pollen-robotics/power-supply-board/power_supply_board.step

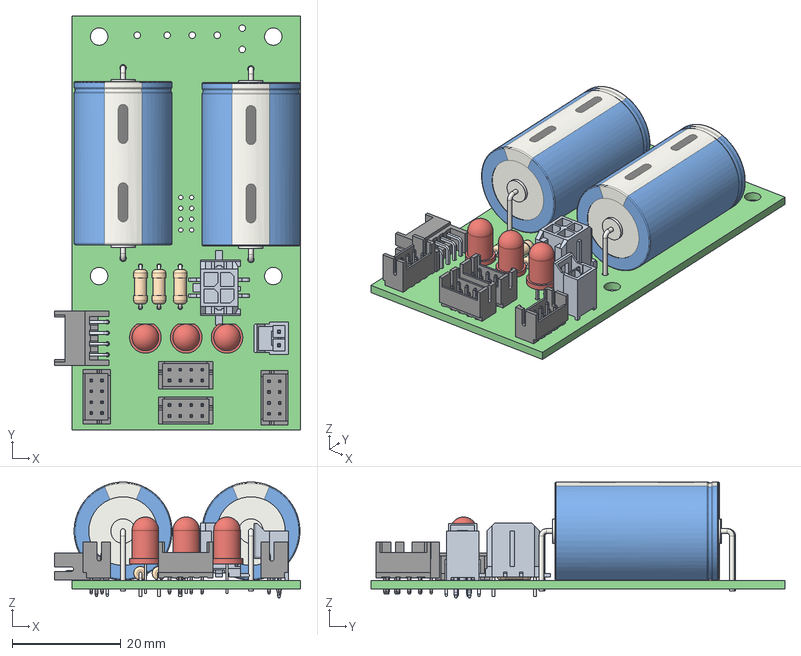
[picture p2: CAD file, 2021-06-08]
power_supply_board.step
45.2 x 76.0 x 21.3 mm
