pollen-robotics/power-supply-board/3D_components/DF11-8DP-2DSA.stp

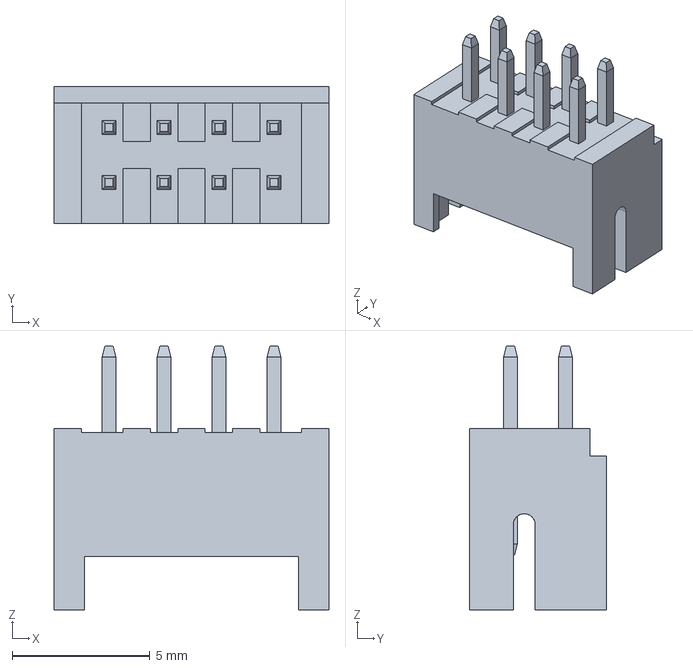
[picture p3: CAD file, 2021-02-04]
3D_components/DF11-8DP-2DSA.stp
10.0 x 5.00 x 9.60 mm
