pollen-robotics/power-supply-board/3D_components/Molex_Nano-Fit_105313-xx02_1x02_P2.50mm_Horizontal.stp

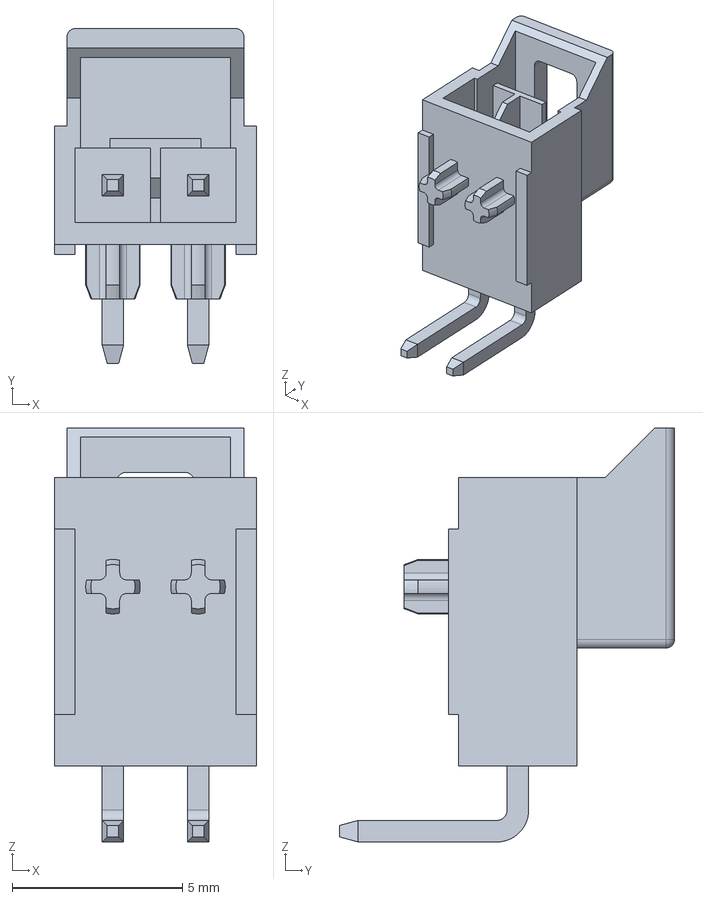
[picture p4: CAD file, 2020-03-27]
3D_components/Molex_Nano-Fit_105313-xx02_1x02_P2.50mm_Horizontal.stp
5.94 x 9.84 x 12.2 mm
