pollen-robotics/power-supply-board/3D_components/Molex_Mini-Fit_Jr_5569-04A2_2x02_P4.20mm_Horizontal.stp

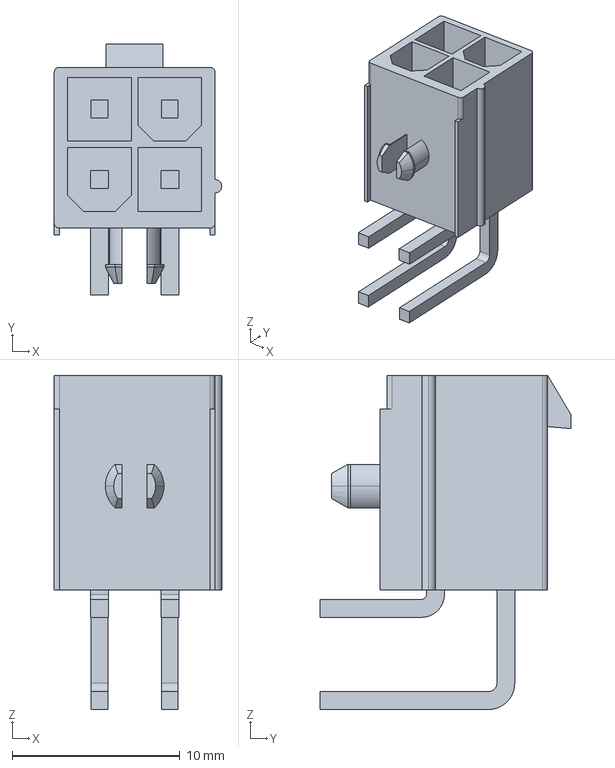
[picture p5: CAD file, 2020-03-27]
3D_components/Molex_Mini-Fit_Jr_5569-04A2_2x02_P4.20mm_Horizontal.stp
10.0 x 15.0 x 19.9 mm
