pollen-robotics/power-supply-board/3D_components/430450418.stp

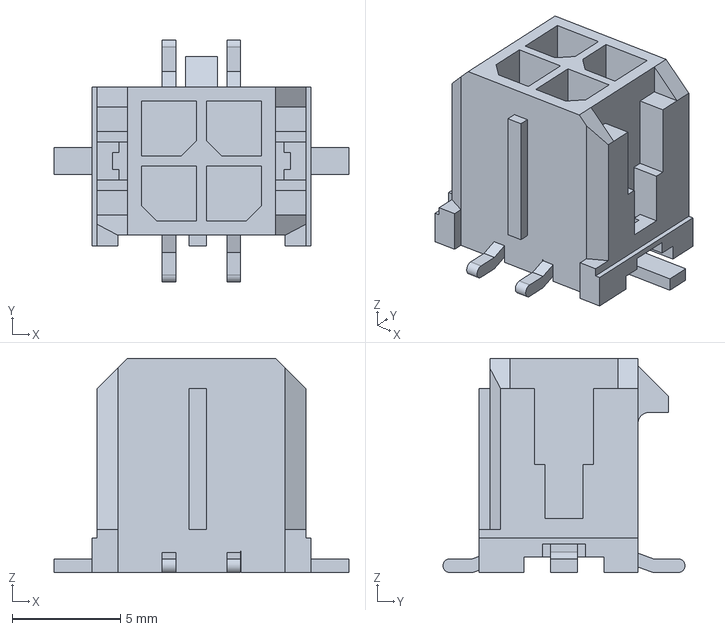
[picture p6: CAD file, 2021-02-04]
3D_components/430450418.stp
13.7 x 11.2 x 9.91 mm
