pollen-robotics/power-supply-board/power_supply_board_schematic.pdf

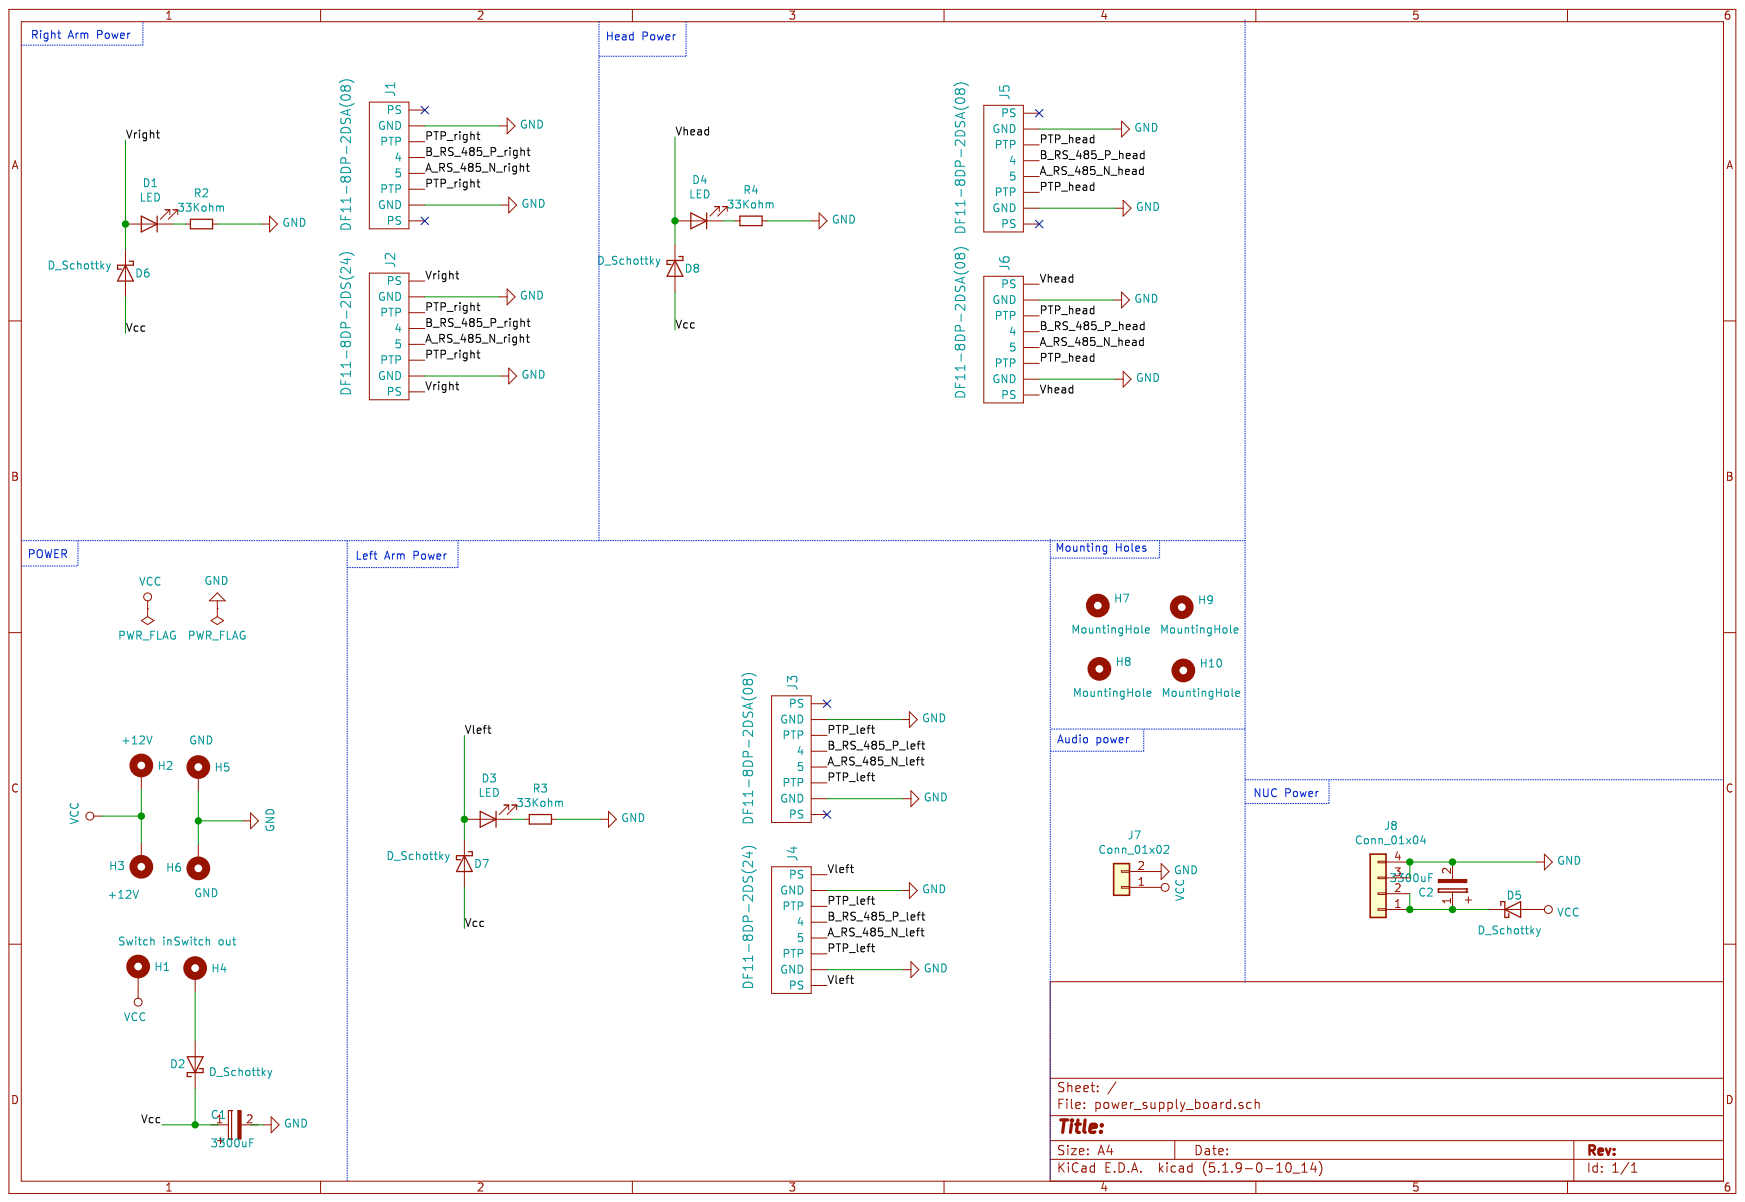
[picture p7: page 1]
