pollen-robotics/power-supply-board/(commit log)

2020-03-27 Add the KiCad project
    [alim_board.kicad_pcb, alim_board.sch]
2020-03-27 Add the connector's 3D models
    [Molex_Mini-Fit_Jr_5569-04A2_2x02_P4.20mm_Horizontal.stp, Molex_Nano-Fit_105313-xx02_1x02_P2.50mm_Horizontal.stp]
2020-04-09 Improve pads-zones connections and silkscreen. Add a step file of the pcb
    [alim_board.kicad_pcb, alim_board.step]
2021-02-04 New version of the power supply board of reachy
    [430450418.stp, DF11-8DP-2DSA.stp, alim_board.kicad_pcb, alim_board.sch, alim_board.step, power_supply_board.step, reachy_power.kicad_pcb, reachy_power.sch]
2021-02-04 Fix readme and names of project
    [power_supply_board.kicad_pcb, power_supply_board.sch]
2021-02-19 Fix silkscreen
    [power_supply_board.kicad_pcb]
2021-02-19 Add capa and diod to keep the nuc powered. Add a molex connector for audio power Change footprints of capa and diods
    [power_supply_board.kicad_pcb, power_supply_board.sch]
2021-02-22 Fix pcb issues and add order codes of components
    [power_supply_board.kicad_pcb, power_supply_board.sch]
2021-02-22 Change right arm robus connector remove working files
    [power_supply_board.kicad_pcb, power_supply_board.sch]
2021-02-22 change some tracks and logo
    [power_supply_board.kicad_pcb]
2021-04-12 two bulk capa version, no NTC
    [power_supply_board.kicad_pcb, power_supply_board.sch]
2021-06-08 Update 3D model
    [power_supply_board.kicad_pcb]
2021-06-08 Update README and step files.
    [power_supply_board.step]
2021-06-28 Change seller codes.
    [power_supply_board.sch]
2023-01-10 Add the pdf of the schematic.
2023-01-10 Update Silkscreen and add pcb pdf.
    [power_supply_board.kicad_pcb]
